MateoVelasquez/Nero_3dprinter/README.md

# Nero_3dprinter
Creación de impresora 3D casera.

# Indice del repositorio
* CAD - Archivos CAD de las piezas de la impresora.
  * _designed - Archivos CAD diseñados especificamente para ser impresos en 3D y usarse en este proyecto.
  * _standar_parts - Archivos CAD de piezas estandar que hacen parte del proyecto. (dispositivos electronicos, actuadores, etc)
  * e3d_titan_extruder_assembly - Contiene los archivos y ensambles del extrusor e3d V6 hotend y Titan.
    * designed - Archivos CAD diseñados para ser impresos en 3D y usarse en este proyecto.
    * standar_pieces - Componentes estandar del extrusor e3d hotend y Titan.
  * LCD12864 - Componentes de la pantalla LCD12864
    * designed - Piezas diseñadas para el Case de la pantalla.
    * standar_pieces - Componentes de la pantalla LCD.
* Docs - Documentos varios acerca del proyecto.
* Firmware - El firmware usado para esta impresora es una configuración de Marlin. Mas datos sobre este firmware se pueden encontrar en su [pagina oficial](https://marlinfw.org/)
  * Interface_design_LCD12864 - Contiene imagenes de diseño para el inicio y la interfaz de la pantalla.
  * Marlin-1.1.9_NeroV4 - Codigo y configuración de Marlin.
* Slicer_Profiles - Perfiles de configuracion de la impresora para algunos Slicers.
  * Repetier_Cura_Configuration - Perfil de configuración para Repetier-Host con Cura Engine. El Slicer Repetier se puede obtener desde su [pagina principal](https://www.repetier.com/)
