MateoVelasquez/Nero_3dprinter/Materiales.xlsm

Sheet: Tabla Interactiva
ELEMENTOS NECESARIOS NERO MV4.5 |  |  |  |  |  |  |  |  | RESUMEN
Elemento | $ | $$ | $$$ | Descripcion | Precio Und (COP) | Cantidad |  | SubTotal | Descripcion | Costo
Partes mecanicas |  |  |  |  |  |  |  | $159800 | Partes Mecanicas | $159800
Acople Flexible |  |  |  | 5x8mm | $5400 | 2 | Und | $10800 | Partes Electronicas | $356500
Tuerca Z |  |  |  | T8 trapezoidal | $4800 | 2 | Und | $9600 | Marco | $45600 | *Detalles y lista en Hoja Marco
Correa dentada |  |  |  | GT2 6mm de ancho | $5500 | 2 | mts | $11000 | Partes 3D | $17228.7205 | *Detalles y lista en Hoja Partes 3D
Polea Activa |  |  |  | GT2 16 dientes | $4000 | 2 | Und | $8000 | Tornillos | $14000 | *Detalles y lista en Hoja tornillos
Varilla Lisa |  |  |  | 8mm x 300mm | $5000 | 6 | Und | $30000 | Otros | $11600
Varilla Roscada |  |  |  | Trapezoidal M8 x 300mm | $22000 | 2 | Und | $44000 | TOTAL | $604728.7205
Polea Pasiva |  |  |  | 623zz (o cualquiera 3mm interno) + PLA | $1600 | 2 | Und | $3200
Rodamiento Lineal |  |  |  | LM8UU Metálico | $3600 | 12 | Und | $43200
Rodamiento Radial |  |  |  | Sin Rodamiento Radial Z | $0 | 2 | Und | $0 | NOTA: * Las partes en 3D estan calculadas sin costo de mano de obra
Partes Electronicas |  |  |  |  |  |  |  | $356500 | KEY=4444
Board |  |  |  | Arduino MEGA + RAMPS | $60000 | 1 | Und | $60000
Driver PaP |  |  |  | a4988 + Disipador | $7600 | 5 | Und | $38000
Motores |  |  |  | NEMA 17 0.8A Usado ML | $20000 | 4 | Und | $80000
Cabezal Extrusor |  |  |  | e3d V6 + Titan | $90000 | 1 | Und | $90000
Fuente |  |  |  | 12V 10A ( No soporta uso de Cama Caliente) | $35400 | 1 | Und | $35400
Ventilador Capa |  |  |  | 40mm Normal | $3800 | 1 | Und | $3800
EndStop |  |  |  | MicroSwitch Sencillo | $700 | 3 | Und | $2100
Pantalla |  |  |  | LCD 12864 | $47200 | 1 | Und | $47200
Cama Caliente |  |  |  | Sin Cama | $0 | 1 | Und | $0
Otros |  |  |  |  |  |  |  | $11600
Cables |  |  |  | Ribbon 20 hilos AWG 28 o AWG 26 | $2700 | 3 | mts | $8100
Sujetadores |  |  |  | Sujetadores de seguridad para los cables | $1500 | 1 | pqt | $1500
Conectores |  |  |  | Hembras | $2000 | 1 | pqt | $2000

Sheet: Elementos
LISTA DE COSTES Y MATERIALES
Parte | Referencia | Precio
MECANICA
Acople flexible
 | 5x8mm | 5400 (https://www.didacticaselectronicas.com/index.php/cnc-e-impresoras-3d/acoples-para-motor/acople-para-motor-5mm-x-8mm-x-25mm-acople-5x8x25-eje-detail)
Tuerca | 5/16 normal o M8 | 500
 | T8 trapezoidal | 4800 (https://www.didacticaselectronicas.com/index.php/cnc-e-impresoras-3d/estructura/tuerca-t8-2mm-x-8mm-paa-varilla-trapezoidal-impresora-3d-tuerca-t8-anycubic-cn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)
Correa dentada
 | GT2 6mm de ancho | 5500 (https://www.didacticaselectronicas.com/index.php/cnc-e-impresoras-3d/sincronismo/correa-de-distribuci%C3%B3n-abierta-de-6mm-de-ancho-2gt-6-1m-a-gt2-anycubic-b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)
Polea Activa | GT2 16 dientes | 4000 (https://www.didacticaselectronicas.com/index.php/cnc-e-impresoras-3d/poleas-y-engranajes/polea-2gt-de-sincronismo-de-16-dientes-2gt-8-16-5mm-gt2-detail)
 | GT2 20 dientes | 5600 (https://www.didacticaselectronicas.com/index.php/cnc-e-impresoras-3d/poleas-y-engranajes/polea-2gt-de-sincronismo-de-20-dientes-2gt-9-20-5mm-gt2-gt2-detail)
Varilla lisa | Tuberia aluminio 5/16 | 1000
 | 8mm x 300mm | 5000 (https://articulo.mercadolibre.com.co/MCO-527261841-varilla-lisa-eje-8mm-x-30-cm-acero-plata-printed-3d-o-cnc-_JM)
Varilla rosca | Tornillo esparrago 5/16 x300mm o M8x3000 | 4000
 | Trapezoidal M8 x 300mm | 22000 (https://www.didacticaselectronicas.com/index.php/cnc-e-impresoras-3d/estructura/eje-roscado,-t8-varilla-trapezoidal-roscada-300mm-anycubic-cnc-detail)
Polea Pasiva | 623zz (o cualquiera 3mm interno) + PLA | 1600 (https://www.didacticaselectronicas.com/index.php/cnc-e-impresoras-3d/rodamientos/rodamiento-623zz-balinera-rueda-detail)
 | Polea pasiva dentada | 5400 (https://www.didacticaselectronicas.com/index.php/cnc-e-impresoras-3d/poleas-y-engranajes/polea-pasiva-2gt-de-sincronismo-de-20-dientes,-5mm-rueda-h-2gt-8-20-5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)
 | Polea pasiva lisa | 8000 (https://www.didacticaselectronicas.com/index.php/cnc-e-impresoras-3d/poleas-y-engranajes/gt2-polea-pasiva-lisa-2gt-de-sincr-20-dientes,-5mm-detail)
Rodamientos Lineales | PLA ( o PLA + Teflon) | 200
 | LM8UU Metálico | 3600 (https://www.didacticaselectronicas.com/index.php/cnc-e-impresoras-3d/rodamientos/rodamiento-lineal-largo-8mm-balinera-lm8uu-detail)
 | LM8UU 8mm Plastico | 4800 (https://www.didacticaselectronicas.com/index.php/cnc-e-impresoras-3d/rodamientos/rodamiento-pl%C3%A1stico-solido-para-eje-8mm-detail)
Rodamientos Radiales | Sin Rodamiento Radial Z | 0
 | Rodamiento Radial 8mm (688ZZ o equivalente) | 2000 (https://www.didacticaselectronicas.com/index.php/cnc-e-impresoras-3d/rodamientos/openbuilds,-open-builds-27-detail)
ELECTRONICA
Board | Arduino MEGA + RAMPS | 60000
 | MKS | 160000 (https://www.didacticaselectronicas.com/index.php/cnc-e-impresoras-3d/controladores-cnc-y-3d/tarjeta-de-control-mks-gen-v1-4-pcb-mks-gen-v1-4-controladora-impr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)
Drivers PaP | a4988 + Disipador | 7600 (https://www.didacticaselectronicas.com/index.php/robotica/controladores-1/tarjeta-controlador-controladores-driver-drivers-motor-paso-a-paso-control-stepper-a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)
 | DRV8825 | 9000 (https://articulo.mercadolibre.com.co/MCO-456634264-modulo-drv8825-driver-motor-paso-a-paso-_JM)
 | TCM2110 | 30000 (https://www.didacticaselectronicas.com/index.php/cnc-e-impresoras-3d/controladores-cnc-y-3d/controlador-motor-paso-a-paso-tmc2208-controlador,-driver,-control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)
Motores | NEMA 17 0.8A Usado/Reciclado | 5000
 | NEMA 17 0.8A Usado ML | 20000 (https://articulo.mercadolibre.com.co/MCO-531125661-motor-paso-a-paso-nema-17-bipolar-cnc-arduino-robotica-x4-_JM)
 | NEMA 17 0.4A Nuevo | 52000 (https://www.didacticaselectronicas.com/index.php/cnc-e-impresoras-3d/motores-cnc-y-3d/motor-paso-a-paso-nema-17-42hs34-0404-h%C3%ADbrido-0-4a-step-step-steppe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)
Cabezal Extrusor
 | MK8 | 84000
 | e3d V6 + Titan | 90000
Fuente | 12V 10A ( No soporta uso de Cama Caliente) | 35400 (https://www.didacticaselectronicas.com/index.php/fuentes-adaptadores/fuentes-fijas/12v/fuente-suicheada-12v-10a-120w-swicheada-voltaje-poder-detail)
 | 12V 20A | 53000 (https://www.didacticaselectronicas.com/index.php/fuentes-adaptadores/fuentes-fijas/12v/fuente-suicheada-12v-20a-240w-swicheada-voltaje-poder-detail)
 | 12V 30A | 64000 (https://www.didacticaselectronicas.com/index.php/fuentes-adaptadores/fuentes-fijas/12v/fuente-suicheada-12v-30a-3600w-fija-alimentaci%C3%B3n-poder-voltaje-det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)
Ventilador de Capa | 40mm Normal | 3800 (https://www.didacticaselectronicas.com/index.php/cnc-e-impresoras-3d/radiadores-y-ventiladores/ventilador-12v,-65ma,-40mm-x-40mm-x-10mm-vent-40x40x10-anycubic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)
 | 40mm Turbina | 6800 (https://www.didacticaselectronicas.com/index.php/cnc-e-impresoras-3d/radiadores-y-ventiladores/ventilador-soplador-12v,-70ma,-40mm-x-40mm-x-20mm-vent-sop-40x4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)
EndStop | MicroSwitch Sencillo | 700 (https://www.didacticaselectronicas.com/index.php/suiches-y-conectores/suiches/micro-suiche/micro-suiche,-microsuiche,-suiche,-kw4-z1f150-8066-detail)
 | MicroSwitch en Tarjeta | 6000 (https://www.didacticaselectronicas.com/index.php/sensores/contacto-y-choque/sensor-de-choque-endstop-end-stop-final-de-carrera-colisi%C3%B3n-2138-detail)
 | Sensores Opticos (NECESITA MODIFICACION) | 7000 (https://listado.mercadolibre.com.co/final-carrera-optico)
Pantalla | Sin Pantalla | 0
 | LCD 2004 | 44000 (https://www.didacticaselectronicas.com/index.php/cnc-e-impresoras-3d/controladores-cnc-y-3d/lcd-2004-ramps-1-4-para-controlador-de-impresora-3d-lcd2004-ramps-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)
 | LCD 12864 | 47200 (https://www.didacticaselectronicas.com/index.php/cnc-e-impresoras-3d/controladores-cnc-y-3d/lcd-12864-ramps-1-4-para-controlador-de-impresora-3d-12864-ramps-1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)
Cama Caliente | Sin Cama | 0
 | 20x20 MK2B | 38000 (https://www.didacticaselectronicas.com/index.php/cnc-e-impresoras-3d/platos-y-calefactores/plato-caliente-mk2b,-cama-caliente-cuadrada-para-impresora-3d-mk2b-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)
OTROS
Cables | Ribbon 20 hilos AWG 28 o AWG 26 | 2700 (https://www.didacticaselectronicas.com/index.php/cables/ribbon/cable-gris-ribbon-plano-de-20-hilos-cable-flat-20-cable-para-datos,-awg-28-dupont-detail)
Conectores | Hembras | 2000
Sujetadores | Sujetadores de seguridad para los cables | 1500

Sheet: Marco
Marco |  |  | Costo del minuto de corte LASER | $800
Descripcion | Tiempo de mecanizado (minutos) | Costo
MDF 6mm 40cm x 50cm | N/A | $9000
MDF 6mm 43cm x 43cm | N/A | $7000
Corte LateralesDXF | 19 | $15200
Corte MarcoDXF | 18 | $14400
TOTAL |  | $45600

Sheet: Partes 3D
PARTES IMPRESAS EN 3D |  |  |  |  |  |  |  |  | *Nota: No se incluye costo de honorarios y gastos extra
Parte | cantidad de filamento (mm) | Peso (gr) | Horas | Min | Tiempo (horas) | Costo |  |  | *Nota: Todos los valores fueron calculados con 20% de infill, capas de 0.3mm y velocidad de 40mm/s
Soporte Motor Extrusor | 11479 | 34.26429623 | 2 | 45 | 2.75 | $2510.650663 |  |  | *Nota: El costo se calculó sobre los siguientes valores (Pesos Colombianos)
Soporte Ventilador Capa | 5083 | 15.17252529 | 1 | 30 | 1.5 | $1147.869093 | Costo de Hora | $128.00
Carro X parte 1 | 8085 | 24.13335962 | 2 | 0 | 2 | $1776.401656 | Costo de gramo | $63.00
Carro X parte 2 | 8136 | 24.28559231 | 2 | 0 | 2 | $1785.992316
Soporte EndStop X | 953 | 2.844661931 | 0 | 13 | 0.2166666667 | $206.947035
Soporte EndStop Z | 937 | 2.796902655 | 0 | 14 | 0.2333333333 | $206.0715339
Separador Motores Z | 3463 | 10.3368985 | 0 | 52 | 0.8666666667 | $762.1579387
Soporte Motor Y | 6727 | 20.07979099 | 1 | 42 | 1.7 | $1482.626832
Soporte Polea Y | 1425 | 4.253560601 | 0 | 21 | 0.35 | $312.7743178
Camisa para Correa Y | 1990 | 5.940060067 | 0 | 28 | 0.4666666667 | $433.9571175
Carro Z Derecha | 10989 | 32.80166838 | 2 | 30 | 2.5 | $2386.505108
Carro Z Izquierda | 17129 | 51.1292909 | 4 | 7 | 4.116666667 | $3748.07866
Camisa Rodamientos Y | 2152 | 6.423622745 | 0 | 30 | 0.5 | $468.688233
TOTAL |  |  |  |  |  | $17228.7205

Sheet: Tornillos
TORNILLOS
Tabla Detallada |  |  |  |  | Tabla Resumen
Tipo | Longitud | Cantidad | Observaciones | Total | Tipo | Longitud | Cantidad
.----------------------------------------------Extrusor---------------------------------------------- |  |  |  | 14 | M3 | 10 | 11
M3 | 10 | 4 | Fan 4mm |  | M3 | 12 | 12
M3 | 16 | 6 | LCD case(4), Fan Soporte(2) |  | M3 | 16 | 54 | 30 | *
M3 | 16 | 1 | Carro X |  | M3 | 20 | 8 | 24 | *
M3 | 25 | 3 | Carro X |  | M3 | 25 | 11
.------------------------------------Estructura Madera------------------------------------------ |  |  |  | 46 | M4 | 16 | 20
M3 | 16 | 8 | Base Frontal y Trasera |  | TOTAL TORNILLOS |  | 116
M3 | 16 | 6 | Base Lateral-Marco
M3 | 16 | 12 | Escuadras |  | Precio Aproximado |  | $14000.00
M3 | 16 | 8 | Soportes Z (izq y der)
M3 | 16 | 4 | Tope Z (izq y der) |  | * Nota: Si la estructura tiene doble frontales, entonces son M3x20 = 24 y M3x16 = 30
M3 | 16 | 4 | Bobina soporte
M3 | 20 | 4 | Soporte Cama
.------------------------------------Estructura Mecanica------------------------------------------ |  |  |  | 36 | ** Se recomienda comprar por docenas
M3 | 10 | 4 | Motor X
M3 | 10 | 3 | Motor Y
M3 | 12 | 8 | Tuerca Trapezoidal (izq + der)
M3 | 12 | 4 | Soporte Motor Y
M3 | 16 | 4 | Soporte polea Y
M3 | 16 | 1 | Ajustador altura Z
M3 | 20 | 3 | LCD soportes(2), Polea X(1)
M3 | 20 | 1 | Polea Y
M3 | 25 | 8 | Motor Z + Separador (Izq y Derecha)
.------------------------------------Rodamientos------------------------------------------ |  |  |  | 20
M4 | 16 | 20 | Rodamientos +holder correa Y
 |  | NUMERO TOTAL DE TORNILLOS |  | 116
