MateoVelasquez/Nero_3dprinter/(threads)

Thread 12 (2020-11-20):

Rediseñar el ensamble para el extrusor e3d

MateoVelasquez, 2020-11-20:
La distribución de pesos en el extrusor provoca que se incline hacia adelante, como mejora se puede rediseñar la pieza pensando una mejor distribución de peso

MateoVelasquez, 2021-02-10:
Este diseño solo soporta ventiladores de 404010 y 4010 tipo turbina, adicionalmente se debería realizar un segundo diseño para usar los ventiladores por defecto.

MateoVelasquez, 2021-03-04:
En el diseño actual es necesario reducir o elevar la pared inferior un poco ya que está quedando demasiado cerca al fusor, lo que podría provocar que este elemento se derrita en un futuro cercano.

Thread 3 (2020-11-20):

Rediseñar poleas

MateoVelasquez, 2020-11-20:
Rediseñar poleas para que sean compactibles con rodamientos 623 de 3mm interno.

**IMPORTANTE**
Es necesario también rediseñar la perforación de las piezas que soportan las poleas (bajar de 4mm a 3mm)

Thread 4 (2020-11-20):

Varillas sueltas en el eje Y

MateoVelasquez, 2020-11-20:
Las varillas en el eje Y no quedan bien sujetas y se deslizan con el movimiento de la cama, pudiendo llegar a salirse durante impresiones en curso.

Posibles Opciones:
-Ajustar mas la perforacion de Y
- Diseñar unas piezas para sujetar la varilla en el eje Y

Thread 7 (2020-11-20):

Reducir abertura de los holders de finales de carrera.

MateoVelasquez, 2020-11-20:
Reducir la abertura de los portadores de finales de carrera para que entren a presión.

MateoVelasquez, 2021-02-20:
Las monturas de los finales de carrera del eje Z son compactibles con el eje X.
Adicionalmente, esta abertura se redujo en esta nueva versión en el commit b4e254613bb8ba489d9f63621ab6ed7355546921

Closed 2021-02-20.

Thread 9 (2020-11-20):

Ampliar espacio en el braket Y

MateoVelasquez, 2020-11-20:
El bracket que ata la correa del eje Y a la cama tiene la abertura para encajarla muy pequeña, es necesario ampliar este espacio para facilitar el armado de la impresora.

Thread 15 (2020-12-20):

Reemplazar Pololu a4988 por Trinamic  TMC 2208

MateoVelasquez, 2020-12-20:
Actualmente se usan Drivers A4988 que se pueden  reemplazar con los TMC 2208 con el fin de insonorizar mas la impresora.
Es necesario encontrar el valor de la corriente  actual en los motores para calibrar los drivers. TMC 2208.

MateoVelasquez, 2020-12-27:
DRIVERS BASADOS EN ALLEGRO A4988
--------------------------------------------

Los drivers A9488, según el datasheet, se calibran basados en la siguiente formula:

                              Imax = Vref / ( 8 * Rs)

Donde, Imax es la corriente máxima que circulará en el motor, Vref es el voltaje de referencia calibrado en la placa del driver y Rs la resistencia de la placa.
En el caso de los motores Minebea usados en esta maquina y la placa del driver a4988, los datos son lo siguientes:
- Imax = 0.8A
- Rs = 0.100 ohms

Lo que resulta en un valor Vref = 0.68.
**NOTA** : Por seguridad, es mejor trabajar con el 70% del Voltaje de referencia calculador. Por tanto, el voltaje de referencia usado en esta maquina es:
**Vref = 0.44**

MateoVelasquez, 2020-12-27:
DRIVERS BASADOS EN TRINAMIC TCM 2208
-------------------------------------------------

Los drivers Trinamic TCM 2208, según el datasheet (https://www.trinamic.com/fileadmin/assets/Products/ICs_Documents/TMC220x_TMC2224_datasheet_Rev1.09.pdf), se calibran basados en la siguiente formula:

                                        Irms = 325 mV / (Rs + 30mΩ) * 1/sqrt(2) * Vref/2.5

Donde, Irms es la corriente máxima que circulará en el motor, Vref es el voltaje de referencia calibrado en la placa del driver y Rs la resistencia de la placa.
En el caso de los motores Minebea usados en esta maquina y la placa del driver TMC 2208 v2.0, los datos son lo siguientes:

Imax = 0.8A  --> (Irms =  Imax * 1/sqrt(2) =  0.56A)
Rs = 0.110 ohms

Lo que resulta en un valor de calibración de 0.86v

**NOTA:** Por seguridad es mejor usar el 90% del valor calculado, entonces:
**Vref = 0.77v**

MateoVelasquez, 2020-12-28:
Es necesario tambien, reconfigurar las direcciones del movimiento ya sea mediante firmware o con las conexiones en la placa,  ya que los driver Trinamic TCM 2208 invierten la polaridad del pin que controla la direccion.

Closed 2020-12-28.
