MateoVelasquez/Nero_3dprinter/(commit log)

2020-11-15 Se agrega el firmware configurado para la maquina
    [Configuration.h, Configuration_adv.h]
2020-11-15 Se agrega diseño para la interfaz
2020-11-15 Se agrega lista de materiales y lista de materiales interactiva
    [Materiales.xlsm, Materiales.xlsx]
2020-11-15 Se agregan archivos de configuracion para repetier-host con CuraEngine
2020-11-15 Agregado diseño cad de Case y pantalla LCD12864
    [LCD_and_Case.cfg]
2020-11-15 Eliminado cfg innecesario
    [LCD_and_Case.cfg]
2020-11-15 Se movieron estos archivos a la carpeta LCD12864
2020-11-15 Renombrada la carpeta para el extrusor titan
2020-11-15 Agregado ensamble de extrusor e3d y su holder
2020-11-15 Se organizaron los archivos para diferenciar diseñados de estandares
2020-11-16 Se agrega ensamble Nero_V4_5 y sus partes relacionadas, pendiente la agregacion del carro X
2020-11-20 Agregado carro X y ensamble de extrusor al ensamble principal
2021-01-19 Eliminada version vieja de piezas de extrusor
2021-02-04 Se movio la abertura de modo que la correa se pudiera tensar mas
2021-02-04 Agregadas piezas soporte para extrusor e3d_v6 y ensamble
2021-02-04 Agregada piezas de tope para las varillas de 8mm
2021-02-10 Se diseñan las piezas de soporte #12, se corrige un error que provocaba que el hotend quedara desviado 0.5mm hacia el frente del motor extrusor
2021-02-18 Se corrige un error en la pieza extruder_body donde habia un agujero innecesario y podia alterar el flujo de aire en el ventilador disipador #12
2021-02-18 Se corrige la distancia entre las perforaciones del Fan para que no presente conflicto al momento de crear las relaciones
2021-02-18 Se rediseñan las monturas para los Endstop del eje Z #10
2021-02-18 Se reorganiza el arbol del proyecto
    [Configuration.h, Configuration_adv.h]
2021-02-18 Agregado archivo inutil de prueba
